pit3rGit/HSP2/kicad_warstwy.docx

#### 5.3.2. Pary warstw technicznych

Kleju (F.Adhes i B.Adhes)

Warstwy kleju są używane przy mocowaniu elementów SMD za pomocą kleju w przypadku obwodów drukowanych, których montaż odbywa się przez lutowanie na fali (Wave soldering).

Pasty (F.Paste i B.Paste)

Warstwy pasty lutowniczej (Solder Paste) dla elementów SMD są używane do produkcji szablonów pozwalających aplikować pastę lutowniczą wyłącznie na polach lutowniczych przeznaczonych dla elementów montowanych powierzchniowo w piecach rozpływowych (Reflow soldering). Teoretycznie tylko elementy montowane powierzchniowo zajmują te warstwy.

Opisowa (F.SilkS i B.SilkS)

Warstwy opisowe są używane do rysowania uproszczonych obrysów elementów. Są przeznaczone do rysowania grafiki przedstawiającej polaryzację elementu, znaczników desymetryzujących, referencji, czy też zwykłych tekstów z opisem.

Maski (F.Mask i B.Mask)

Warstwy anty-cynowania definiują maskę wykorzystywane przy wstępnym cynowaniu PCB. Normalnie wszystkie pola lutownicze jakie znajdują się na jednej (montaż SMT) lub na obu stronach (montaż THT) są maskowane, aby zapobiegać pokryciu ich lakierem (zwanym popularnie Soldermaską) w końcowym procesie produkcyjnym.

Otoczenia (F.CrtYd i B.CrtYd)

Używane do określania ile miejsca fizycznie zajmuje komponent na płytce PCB z zapasem dla automatów montujących.

Produkcyjna (F.Fab i B.Fab)

Używane do rysowania planu rozkładu elementów na płytce. Plan ten jest wykorzystywany przy programowaniu automatów montujących elementy i przy finalnym sprawdzaniu poprawności obsadzenia tych elementów.

#### 5.3.3. Niezależne warstwy techniczne

Krawędziowa (Edge.Cuts)

Warstwa ta jest zarezerwowana dla graficznego opisu obramowania płytki. Dowolny element (grafika, tekst, element pozycjonujący…) umieszczony na tej warstwie zostanie przeniesiony na pozostałe warstwy.

Marginesu (Margin)

Warstwa ta jest przeznaczona do narysowania obrysu elementów wystających poza płytkę.

#### 5.3.4. Warstwy dla własnego użytku

Warstwy te można używać swobodnie. Można na nich przykładowo umieszczać teksty instrukcji dla montażystów lub z opisem połączeń, albo też rysunki konstrukcyjne. Ich nazwy to:

- Cmts.User - Warstwa przeznaczona na komentarze użytkownika
- Eco1.User - Warstwa przeznaczona na komentarze dla wytwórcy PCB
- Eco2.User - Warstwa przeznaczona na komentarze dla wytwórcy PCB
- Dwgs.User - Warstwa przeznaczona na rysunki użytkownika
