pit3rGit/HSP2/datasheet/cap footprint.PNG

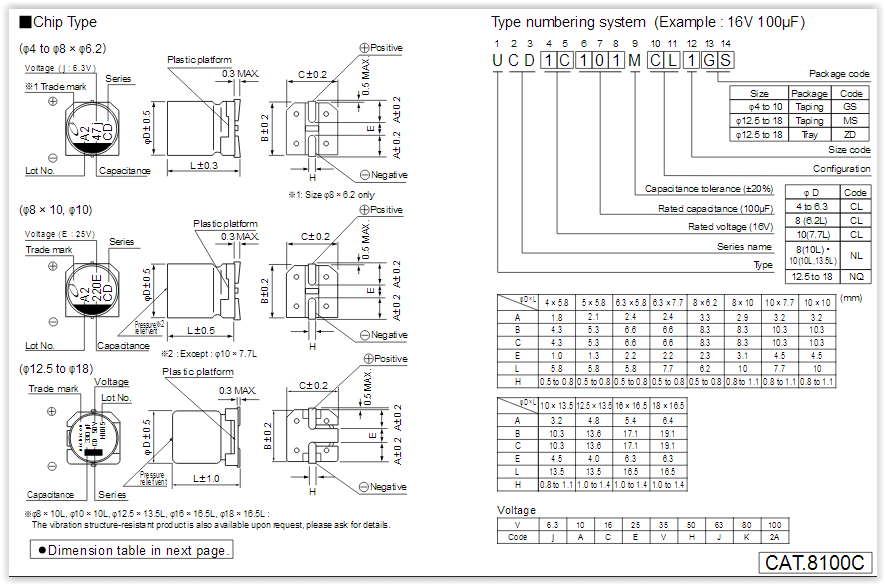
datasheet/cap footprint.PNG
