pit3rGit/HSP2/kosztorys.xlsx

Sheet: PCB
Typ | Producent | Wartość | Obudowa | Ilość | Cena 1 szt. (netto) | Cena całkowita (N szt.) | Ilość do zakupu | Kupiono
Rezystor |  | 1k | 0603R | 21 | 0.004 | 0.08 | 105 | 200
Rezystor |  | 100k | 0603R | 19 | 0.004 | 0.08 | 95 | 100
Rezystor |  | 68k | 0603R | 2 | 0.004 | 0.01 | 10 | 100
Rezystor |  | 60 | 0603R | 1 | 0.004 | 0.004 | 5 | 100 | 60,4 ohma |  | kupione w tme
Rezystor |  | 10k | 0603R | 8 | 0.004 | 0.03 | 40 | 5000
Rezystor |  | 270 | 0603R | 4 | 0.004 | 0.02 | 20 | 100
Rezystor |  | 0 | 0603R | 1 | 0.004 | 0.004 | 5 | 100
Rezystor |  | 200 | 0603R | 1 | 0.004 | 0.004 | 5 | 100
Rezystor |  | 47k | 0603R | 2 | 0.004 | 0.01 | 10 | 50
Rezystor |  | 390 | 0603R | 1 | 0.004 | 0.004 | 5 | 100
 |  |  |  |  |  | 0.00 | 0
Tranzystor |  | IRLML6401 | SOT-23 | 6 | 0.83 | 4.98 | 30 | 36 | IRLML6401TRPBF (https://www.tme.eu/pl/details/irlml6401trpbf/tranzystory-z-kanalem-p-smd/infineon-irf/)
Tranzystor |  | BSS138P.215 (http://www.tme.eu/pl/details/bss138p.215/tranzystory-z-kanalem-n-smd/nexperia/) | SOT-23 | 7 | 0.23 | 1.61 | 35 | 40
Tranzystor |  | FDV304P (http://www.tme.eu/pl/details/fdv304p/tranzystory-z-kanalem-p-smd/on-semiconductor-fairchild/) | SOT-23 | 1 | 0.152 | 0.15 | 5 | 25
 |  |  |  |  |  | 0.00 | 0
Kondensator |  | 1U | 0603C | 21 | 0.055 | 1.16 | 105 | 200 | X5R/25V
Kondensator |  | 13,5P | 0603C | 2 | 0.02 | 0.04 | 10 | 100 | 12p | 100 | 15p
Kondensator |  | 18P | 0603C | 2 | 0.02 | 0.04 | 10 | 100
Kondensator |  | 100N | 0603C | 17 | 0.03 | 0.51 | 85 | 200
Kondensator | TPSD476K016R0080 (https://www.tme.eu/pl/details/tpsd476k016r0080/kondensatory-tantalowe-smd/avx/) | 47u | 2917in | 4 | 2.62 | 10.48 | 20 | 20
Kondensator | T520B476M010ATE035 (http://www.tme.eu/pl/details/t520b476m010ate035/kondensatory-tantalowo-polimerowe/kemet/) | 47U | B, 1411 | 0 | 3.93 | 0.00 | 0 |  | Wycofałem. Niezgodna obudowa.
Kondensator | A755KS108M0JAAE013 (http://www.tme.eu/pl/details/a755ks108m0jaae013/kondensatory-polimerowe/kemet/) | 1000U | 8X3,5mm | 3 | 2.72 | 8.16 | 15 | 18
Kondensator |  | 1N | 0603C | 3 | 0.055 | 0.17 | 15 | 100
Kondensator |  | 100P | 0603C | 2 | 0.03 | 0.06 | 10 | 100
 |  |  |  |  |  | 0.00 | 0
Dwie diody schokty'ego |  | MBRB2535CTLT4G (http://www.tme.eu/pl/details/mbrb2535ctlt4g/diody-schottky-smd/on-semiconductor/) | D3PAK | 1 | 6.81 | 6.81 | 5 | 5
dioda LED | LTST-C193KRKT-5A (http://www.tme.eu/pl/details/ltst-c193krkt-5a/diody-led-smd-kolorowe/liteon/) | LED RED | 0603L | 1 | 0.437 | 0.44 | 5 | 5 | BRAK W TME |  | MOUSER | zapytanie | kupione
dioda LED | LTST-C193KGKT-5A (http://www.tme.eu/pl/details/ltst-c193kgkt-5a/diody-led-smd-kolorowe/liteon/) | LED GREEN | 0603L | 2 | 0.437 | 0.87 | 10 | 15
 |  |  |  |  |  | 0.00 | 0
Bezpiecznik | SCHURTER 3412.0115.11 (http://www.tme.eu/pl/details/3412.0115.11/bezpieczniki-smd-0603-superszybkie/schurter/) | 1A | 0603RH | 6 | 2.34 | 14.04 | 30 | 36
Bezpiecznik | 3413.0326.11 (http://www.tme.eu/pl/details/3413.0326.11/bezpieczniki-smd-1206-zwloczne/schurter/) | 7A | 1206RH | 2 | 2.69 | 5.38 | 10 | 10
Bezpiecznik | Schurter 3413.0010.11 (http://pl.mouser.com/ProductDetail/Schurter/3413001011/) | 250m | 1206RH | 2 | 1.88 | 3.76 | 10 |  | TME |  | MOUSER | zapytanie | brak
Bezpiecznik | SCHURTER 3404.0003.11 (http://www.tme.eu/pl/details/3404.0003.11/bezpieczniki-smd-omf-szybkie/schurter/) | 63m | 7,4x3,1 | 1 | 2.93 | 2.93 | 5 |  | TME |  | MOUSER | zapytanie | brak
 |  |  |  |  |  | 0.00 | 0
Złącze gniazda zewn | Molex | 502584-0670 (http://www.tme.eu/pl/details/mx-502584-0670/zlacza-sygnalowe-raster-150mm/molex/5025840670/) |  | 6 | 2.13 | 12.78 | 30 | 30
Złącze programatora | Molex | 502584-0470 (http://pl.mouser.com/ProductDetail/Molex/502584-0470/) |  | 1 | 1.92 | 1.92 | 5 | 5 | MOUSER |  | MOUSER | zapytanie | kupione
Złącze diody LED | Molex | 502584-0270 (http://pl.mouser.com/ProductDetail/Molex/502584-0270/) |  | 2 | 1.59 | 3.18 | 10 | 10 | MOUSER |  | MOUSER | zapytanie | kupione
Złącze akumulatora | Molex | MX-171813-0004 (http://www.tme.eu/pl/details/mx-171813-0004/zlacza-sygnalowe-raster-396mm/molex/1718130004/) |  | 2 | 2.3 | 4.60 | 10 | 10
Złącze baterii 3,3V | Connfly | DS1092-13-N8S (http://www.tme.eu/pl/details/ds1092-13-n8s/baterie-pojemniki-i-uchwyty/connfly/) |  | 1 | 2.32 | 2.32 | 5 | 10
Złącze karty uSD | Attend | 112C-TBAR-R02 (http://www.tme.eu/pl/details/mcc-sdmicro_1/zlacza-do-kart/attend/112c-tbar-r02/) |  | 1 | 3.73 | 3.73 | 5 | 5
Złącze karty SIM | Amphenol | C707-10M006-049 (http://www.tme.eu/pl/details/c707-10m006-049/zlacza-do-kart/amphenol/c707-10m006-049-2a/) |  | 1 | 3.66 | 3.66 | 5 | 5
 |  |  |  |  |  | 0.00 | 0
Kwarc | Abracon (http://www.tme.eu/pl/details/abs07-32.768khz/rezonatory-kwarcowe-smd/abracon/abs07-32768khz-t/) | ABS07-32.768KHZ (http://www.tme.eu/pl/details/abs07-32.768khz/rezonatory-kwarcowe-smd/abracon/abs07-32768khz-t/) |  | 1 | 5.22 | 5.22 | 5 | 5
Kwarc | ILSI | HC49USM-FF5F8.00 (http://www.tme.eu/pl/details/hc49usm-ff5f8.00/rezonatory-kwarcowe-smd/ilsi/hc49usm-ff5f18-80000/) |  | 1 | 1.76 | 1.76 | 5 | 6
 |  |  |  |  |  | 0.00 | 0
Stabilizator |  | MCP1755T-3302E/DC (http://www.tme.eu/pl/details/mcp1755t-3302e_dc/stabilizatory-napiecia-nieregulowane-ldo/microchip-technology/) | SOT-223-6 | 8 | 4.299 | 34.39 | 40 | 42
Zatrzask |  | 74LVX373M (http://www.tme.eu/pl/details/74lvx373m/zatrzaski/on-semiconductor-fairchild/) | SOIC-20W | 2 | 2.3477 | 4.70 | 10 | 10
RS-485 |  | MAX3485ESA+ (http://www.tme.eu/pl/details/max3485esa+/uklady-scalone-interfejs-rs232422485/maxim-dallas/) | SO-8 | 1 | 22.84 | 22.84 | 5 | 5 | BRAK W TME |  | MOUSER | zapytanie | kupione
Watchdog |  | TPS3823-25QDBVRQ1 (http://pl.rs-online.com/web/p/nadzor-nad-procesorem/7320834/) | SOT-23-5 | 1 | 4.84 | 4.84 | 5 | 5 | RS |  | MOUSER | zapytanie | kupione
ARM |  | STM32L051R8T6 (http://pl.mouser.com/ProductDetail/STMicroelectronics/STM32L051R8T6/) | LQFP-64-10x10 | 1 | 13.9 | 13.90 | 5 | 5 |  |  | MOUSER | zapytanie | kupione
RTC |  | DS3231SN (http://www.tme.eu/pl/details/ds3231sn/uklady-rtc/maxim-dallas/ds3231sn_/) | SO-16-W | 1 | 40.22 | 40.22 | 5 | 5 | BRAK W TME |  | MOUSER | zapytanie | kupione
Stabilizator GSM |  | MIC29302WU (http://www.tme.eu/pl/details/mic29302wu/stabilizatory-napiecia-regulowane-ldo/microchip-micrel/) | TO-263-5 tp6 | 1 | 7.29 | 7.29 | 5 | 5
Czujnik temp i RH |  | DHT22 (https://botland.com.pl/czujniki-temperatury/1612-czujnik-temperatury-i-wilgotnosci-dht22-am2023.html) |  | 1 | 29.9 | 29.90 | 5 | 6 | BOTLAND
GSM |  | M590E (http://www.gotronik.pl/modul-gsm-m590e-zestaw-do-samodzielnego-montazu-p-4067.html) |  | 1 | 16 | 16.00 | 5 | 6 | GOTRONIK
Flash |  | AT45DB161E-SSHD-T (http://www.tme.eu/pl/Document/f6c9d35da09cb9caa899d0d66aa11c4c/AT45DB161E-DTE.pdf) | 8-lead JEDEC SOIC | 1 | 8.7 | 8.70 | 5 | 5
WIFI + BLE |  | ESP-WROOM-32 (https://www.tme.eu/pl/details/esp-wroom-32/moduly-komunikacyjne-pozostale/espressif/) |  | 1 | 20.58 | 20.58 | 5 | 5
 |  |  | SUMA | 178 | SUMA | 304.35
 |  |  |  |  | Liczba PCB | 5.00
 |  |  |  |  | Koszt Całk | 1521.75

Sheet: Obudowa
Nazwa |  |  | Liczba szt. | Całk liczba szt. | Cena 1 szt. | Cena n szt. | Koszt dla n urządzeń | Kupiono
Obudowa | Bopla | Bopla Bocube B 141306 (http://soyter.pl/bopla-uniwersalna-obudowa-bopla-bocube-b-141306-abs-7035-96033225-,c176,p612,pl.html) | 1 | 5 |  | 0 | 0
 |  |  |  | 0 |  | 0 | 0
 |  |  |  | 0 |  | 0 | 0
Złącza zewnętrzne |  |  |  | 0 |  | 0 | 0
Gniazdo sygnalowe | Weipu | SP1312/S6 (http://www.tme.eu/pl/details/sp1312_s6/zlacza-weipu/weipu/) | 6 | 30 | 10.23 | 61.38 | 306.9 | 18
Wtyk sygnałowy | Weipu | SP1310/P6 (http://www.tme.eu/pl/details/sp1310_p6/zlacza-weipu/weipu/sp1310p6i/) | 6 | 30 | 10.84 | 65.04 | 325.2 | 18
 |  |  |  | 0 |  | 0 | 0
 |  |  |  | 0 |  | 0 | 0
Złącza do PCB |  |  |  | 0 |  | 0 | 0
Wtyk 6pin | Molex Clik-Mate | MX-502578-0600 (http://www.tme.eu/pl/details/mx-502578-0600/zlacza-sygnalowe-raster-150mm/molex/5025780600/) | 6 | 30 | 1.14 | 6.84 | 34.2 | 30
styk | Molex Clik-Mate | MX-502579-0000 (http://www.tme.eu/pl/details/mx-502579-0000/zlacza-sygnalowe-raster-150mm/molex/5025790000/) | 44 | 220 | 0.105 | 4.62 | 23.1 | 260
wtyk 4pin | Molex Clik-Mate | MX-502578-0400 (https://www.tme.eu/pl/details/mx-502578-0400/zlacza-sygnalowe-raster-150mm/molex/5025780400/) | 1 | 5 | 1.07 | 1.07 | 5.35 | 8
wtyk 2pin | Molex Clik-Mate | MX-502578-0200 (http://www.tme.eu/pl/details/mx-502578-0200/zlacza-sygnalowe-raster-150mm/molex/5025780200/) | 2 | 10 | 1.02 | 2.04 | 10.2 | 12
wtyk 4pin | KK 396 | MX-2139-4A (http://www.tme.eu/pl/details/mx-2139-4a/zlacza-sygnalowe-raster-396mm/molex/009503041-09-50-3041-2139-4a/) | 2 | 10 | 0.44 | 0.88 | 4.4 | 15
styk do wyboru | KK 396 | MX-2478-1-P913L (http://www.tme.eu/pl/details/mx-2478-1-p913l/zlacza-sygnalowe-raster-396mm/molex/008500106-08-50-0106-2478-1-p909l/) | 0 | 0 |  | 0 | 0 |  | Anulowano wybrano inne
styk do wyboru | KK 396 | MX-6838-P909L (http://www.tme.eu/pl/details/mx-6838-p909l/zlacza-sygnalowe-raster-396mm/molex/008500189-08-50-0189-6838-p909l/) | 8 | 40 |  | 0 | 0 | 70
styk do wyboru | KK 396 | MX-08-52-0072 (http://www.tme.eu/pl/details/mx-08-52-0072/zlacza-sygnalowe-raster-396mm/molex/008520072-2478-3-p909l/) | 0 | 0 |  | 0 | 0 |  | Anulowano wybrano inne
 |  |  |  | Liczba Urządzeń | 5
