pit3rGit/HSP2/datasheet/elementy.ods

Sheet: Sheet1
 | MBRB2535CTLT4G (http://www.tme.eu/pl/details/mbrb2535ctlt4g/diody-schottky-smd/on-semiconductor/) | http://www.tme.eu/pl/details/mbrb2535ctlt4g/diody-schottky-smd/on-semiconductor/#
kond. 2200U | UCD0J222MNL1GS (http://www.tme.eu/pl/details/ucd0j222mnl1gs/kondensatory-elektr-smd-niskoimpedan/nichicon/) | http://www.tme.eu/pl/details/ucd0j222mnl1gs/kondensatory-elektr-smd-niskoimpedan/nichicon/#
kond. MLCC 220u 1210 | CL32A227MQVNNNE (http://www.tme.eu/pl/details/cl32a227mqvnnne/kondensatory-mlcc-smd-1210/samsung/) | http://www.tme.eu/pl/katalog/kondensatory-mlcc-smd-1210_113185/
 | 112C-TBAR-R02 (http://www.tme.eu/pl/details/mcc-sdmicro_1/zlacza-do-kart/attend/112c-tbar-r02/) | http://www.tme.eu/pl/details/mcc-sdmicro_1/zlacza-do-kart/attend/112c-tbar-r02/

Sheet: obliczenia
Stabilizator Wifi
Zakres U | 3,3 | 4,5
Optymalnie | 3,9
Uadj | 1,24
R1 wybrane | 100000
R2 oblczone | 46616,54135
R2 wybrane | 47000
Uwy | 3,878
Pomiar napięcia zasialnia/akumulatora
Napięcie max. | 8 | V
Max. Napięcie ADC | 3,3 | V
R1 wybrane | 100000 | Ohm
R2 oblczone | 70212,76596 | Ohm
R2 wybrane | 68000 | Ohm
U bat max. | 8,152941176 | V
Dla Ubat równego | 6
Uadc wyniesie | 2,428571429 | V
Co da liczbę | 188
Rozdzielczość V | 0,013 | V
