pit3rGit/HSP2/creo/sot-223-6.stl

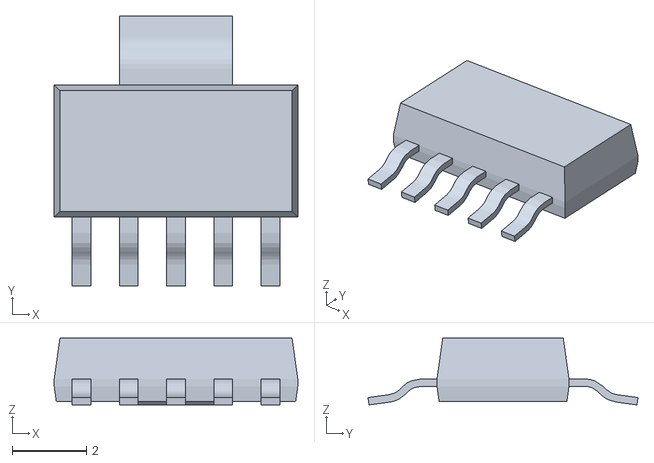
[picture p2: CAD file, 2017-07-28]
creo/sot-223-6.stl
6.55 x 7.26 x 1.80
