pit3rGit/HSP2/creo/dht22.stl

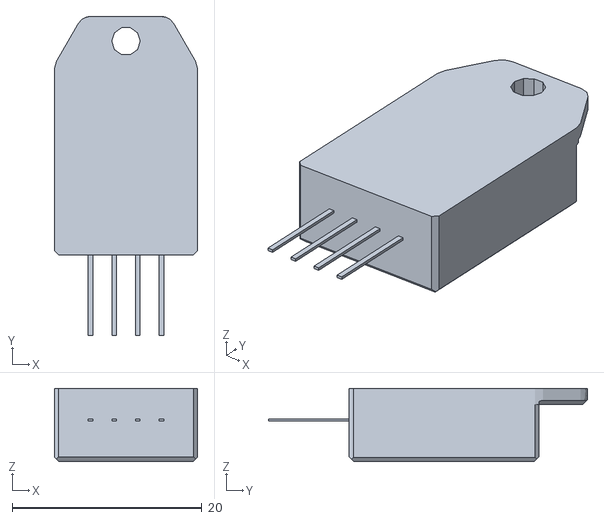
[picture p3: CAD file, 2017-07-28]
creo/dht22.stl
15.1 x 33.6 x 7.70
