pit3rGit/HSP2/creo/WEIPU_SP13_4_Pins.stp

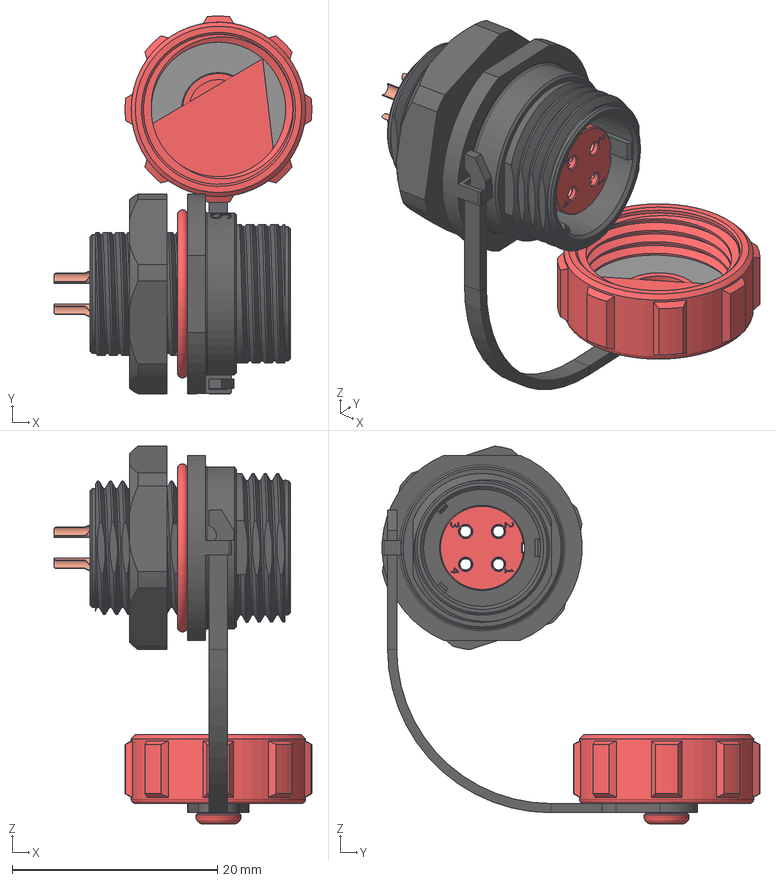
[picture p4: CAD file, 2017-07-27]
creo/WEIPU_SP13_4_Pins.stp
25.1 x 36.8 x 36.8 mm
WEIPU_SP13_4_Pins_Part2
WEIPU_SP13_4_Pins_Part4
WEIPU_SP13_4_Pins_Part5 x 4
WEIPU_SP13_4_Pins_Part3
WEIPU_SP13_4_Pins_Part1
WEIPU_SP13_4_Pins_Part8
WEIPU_SP13_4_Pins_Part6
WEIPU_SP13_4_Pins_Part7
