pit3rGit/HSP2/creo/5025840270.stl

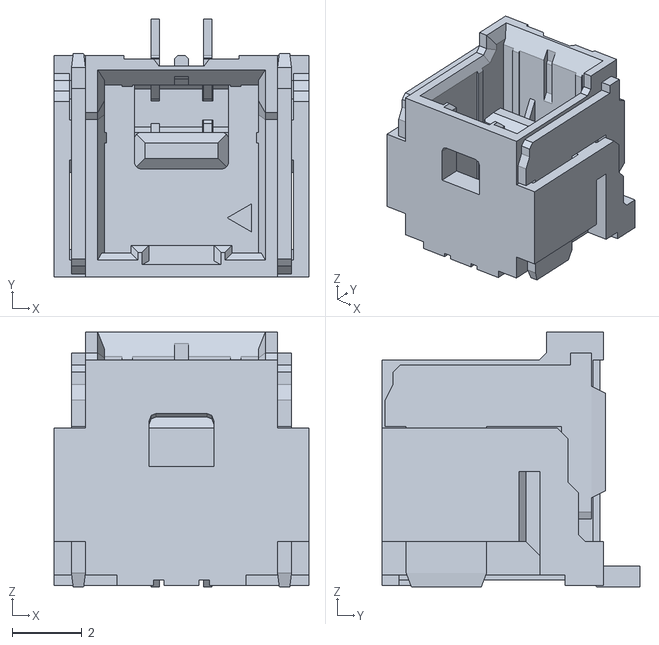
[picture p5: CAD file, 2017-09-05]
creo/5025840270.stl
7.30 x 7.40 x 7.30
