pit3rGit/HSP2/creo/1718130004.stl

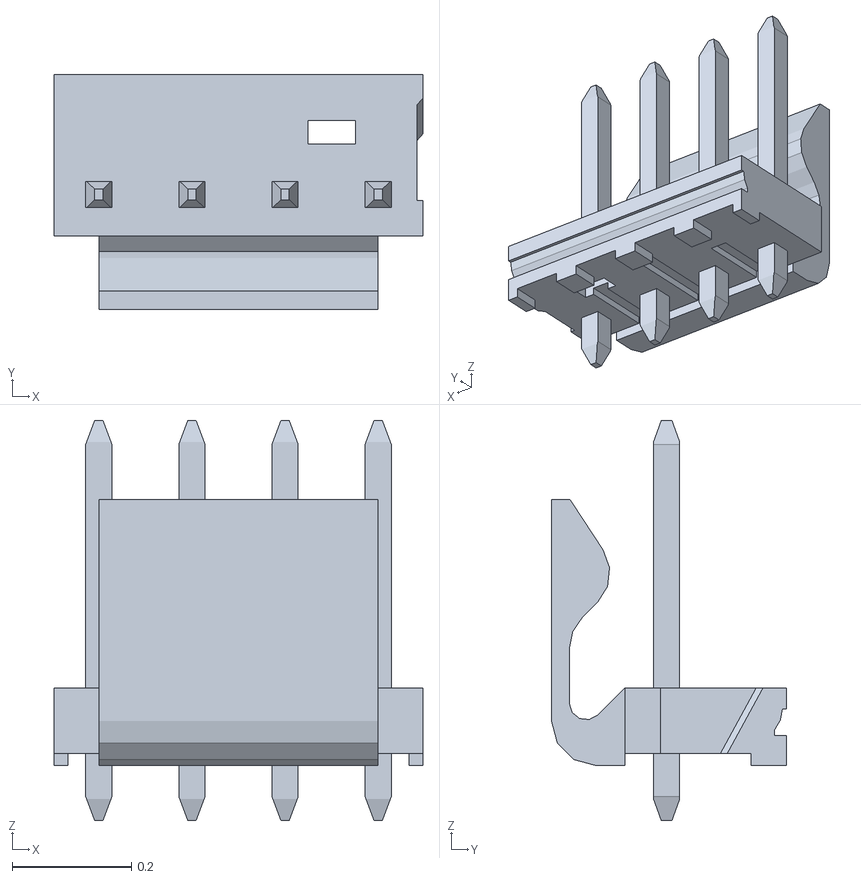
[picture p6: CAD file, 2017-09-05]
creo/1718130004.stl
0.618 x 0.394 x 0.67
