pit3rGit/HSP2/creo/5025840670.stl

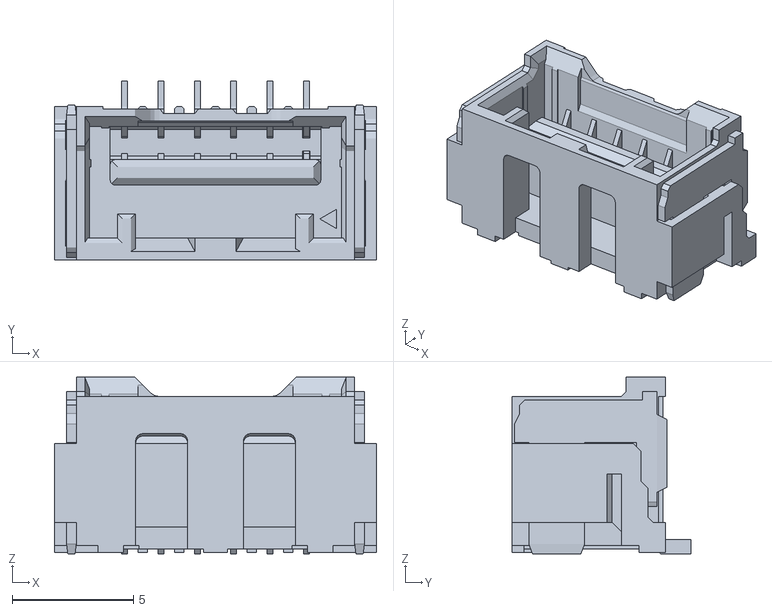
[picture p7: CAD file, 2017-07-28]
creo/5025840670.stl
13.3 x 7.40 x 7.30
