pit3rGit/HSP2/(list of files, cad)

Other CAD files:
creo/1718130004.prt
creo/5025840270.prt
creo/5025840670.prt
creo/SOT-223-6.PRT
