pit3rGit/HSP2/creo/96013225_B_141306_PC-V0_7035.pdf

A-A

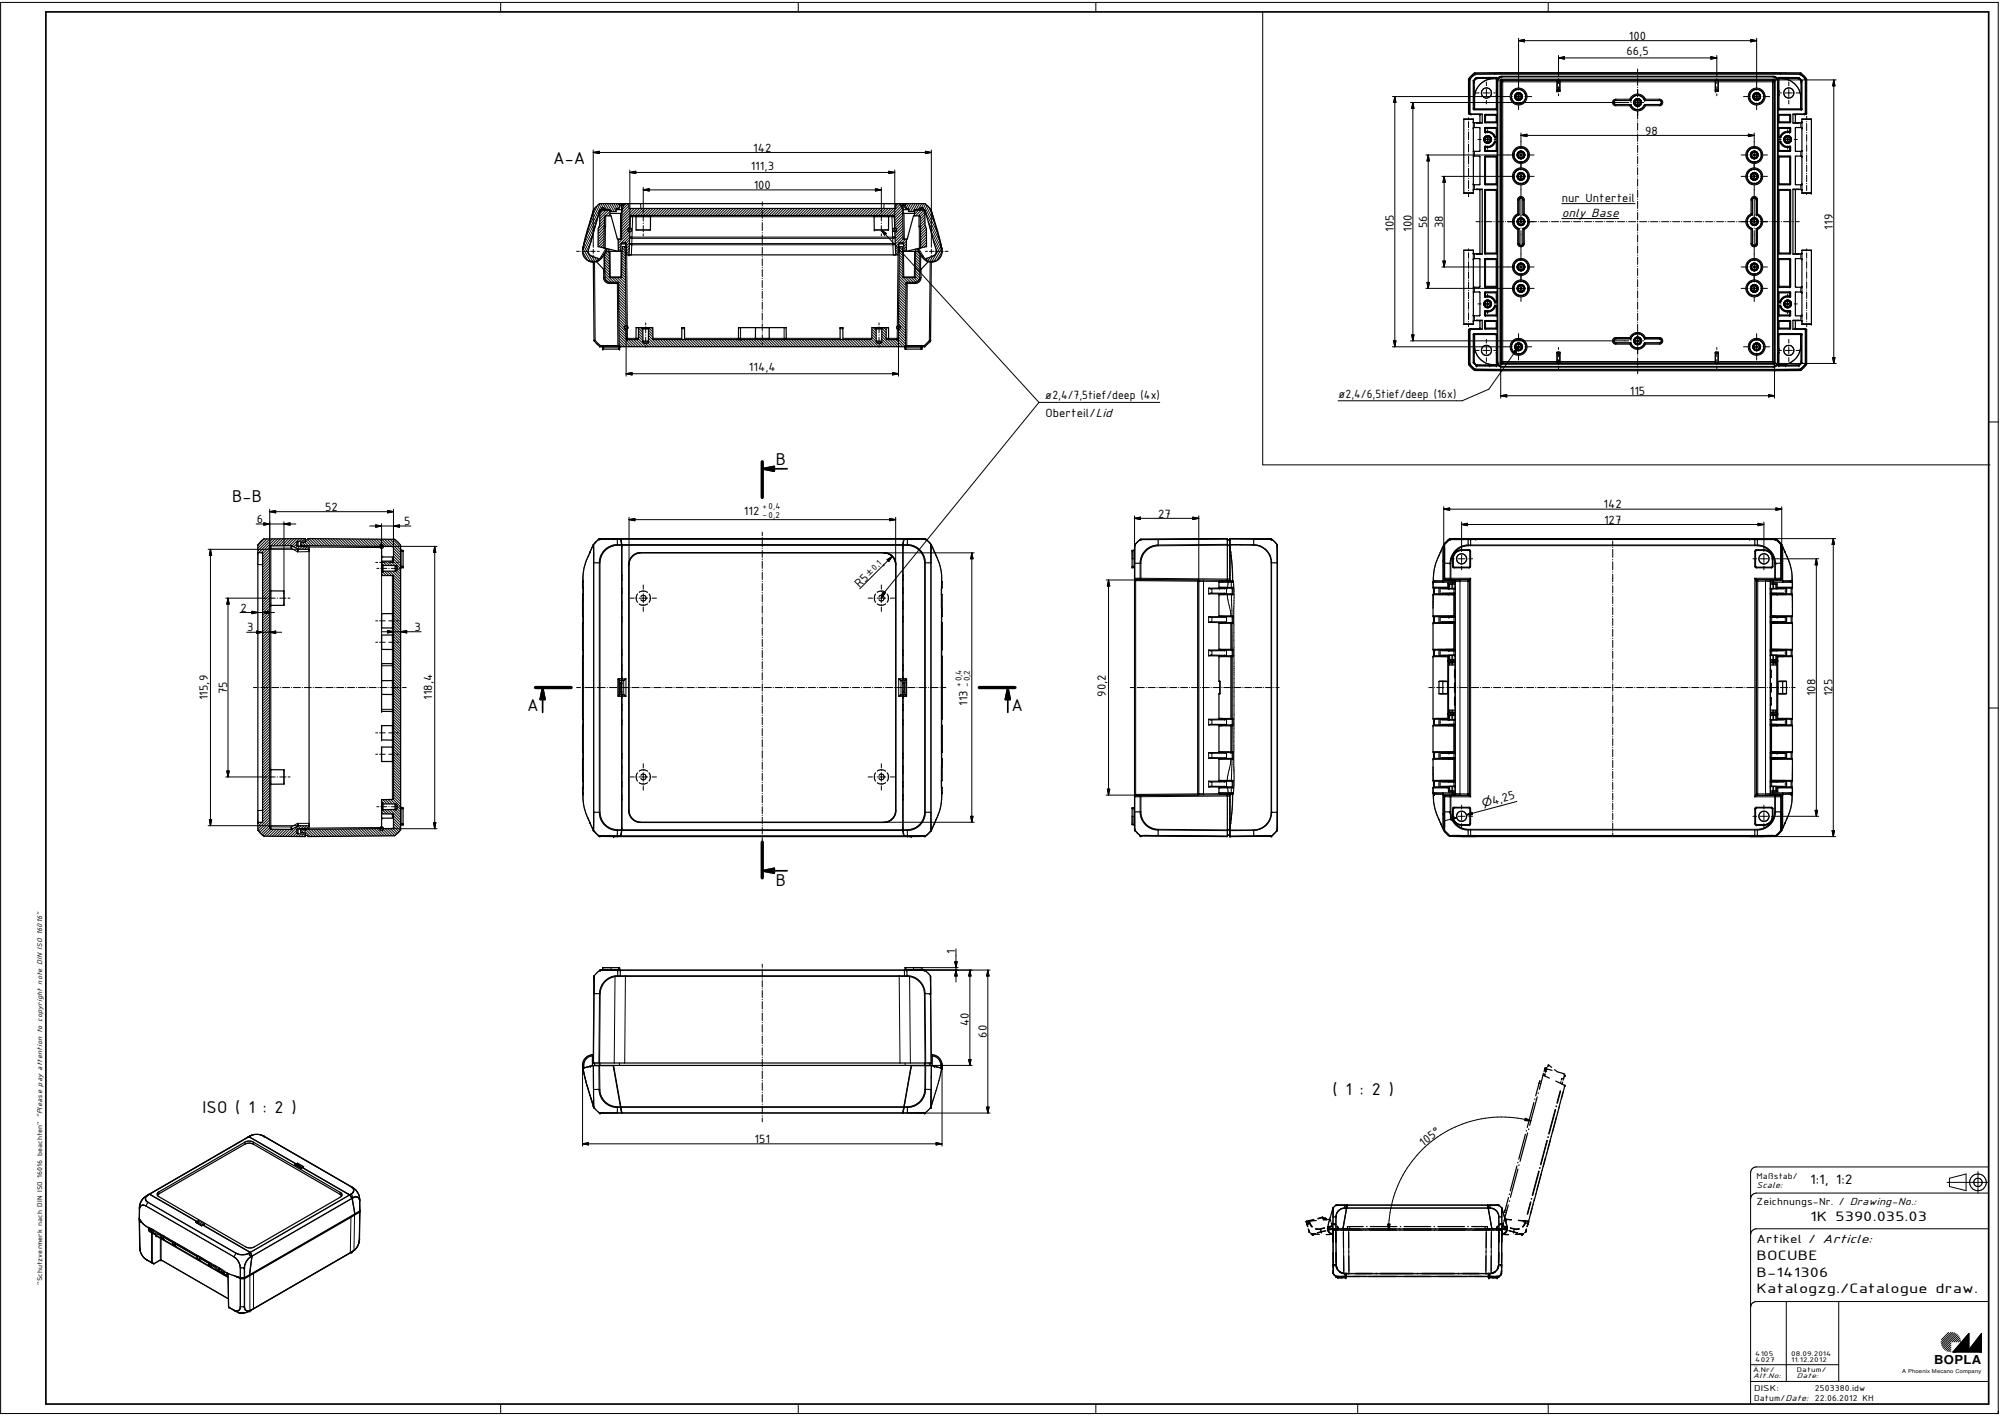
[picture p8: page 1]
ISO ( 1 : 2 ); 2503380.idw 22.06.2012; Datum/; DISK:; Datum/Date:; BOPLA; Alt.No:; Date:; ø2,4/7,5tief/deep (4x); ø2,4/6,5tief/deep (16x); nur Unterteil; only Base; Oberteil/Lid

"Schutzvermerk nach DIN ISO 16016 beachten" "Please pay attention to copyright note DIN ISO 16016"

Maßstab/
Scale:
Zeichnungs-Nr. / Drawing-No.:

Artikel / Article:
BOCUBE
Katalogzg./Catalogue draw.

A Phoenix Mecano Company
