pit3rGit/HSP2/test.kicad_pcb

## KiCad design test.kicad_pcb (2018-01-18)

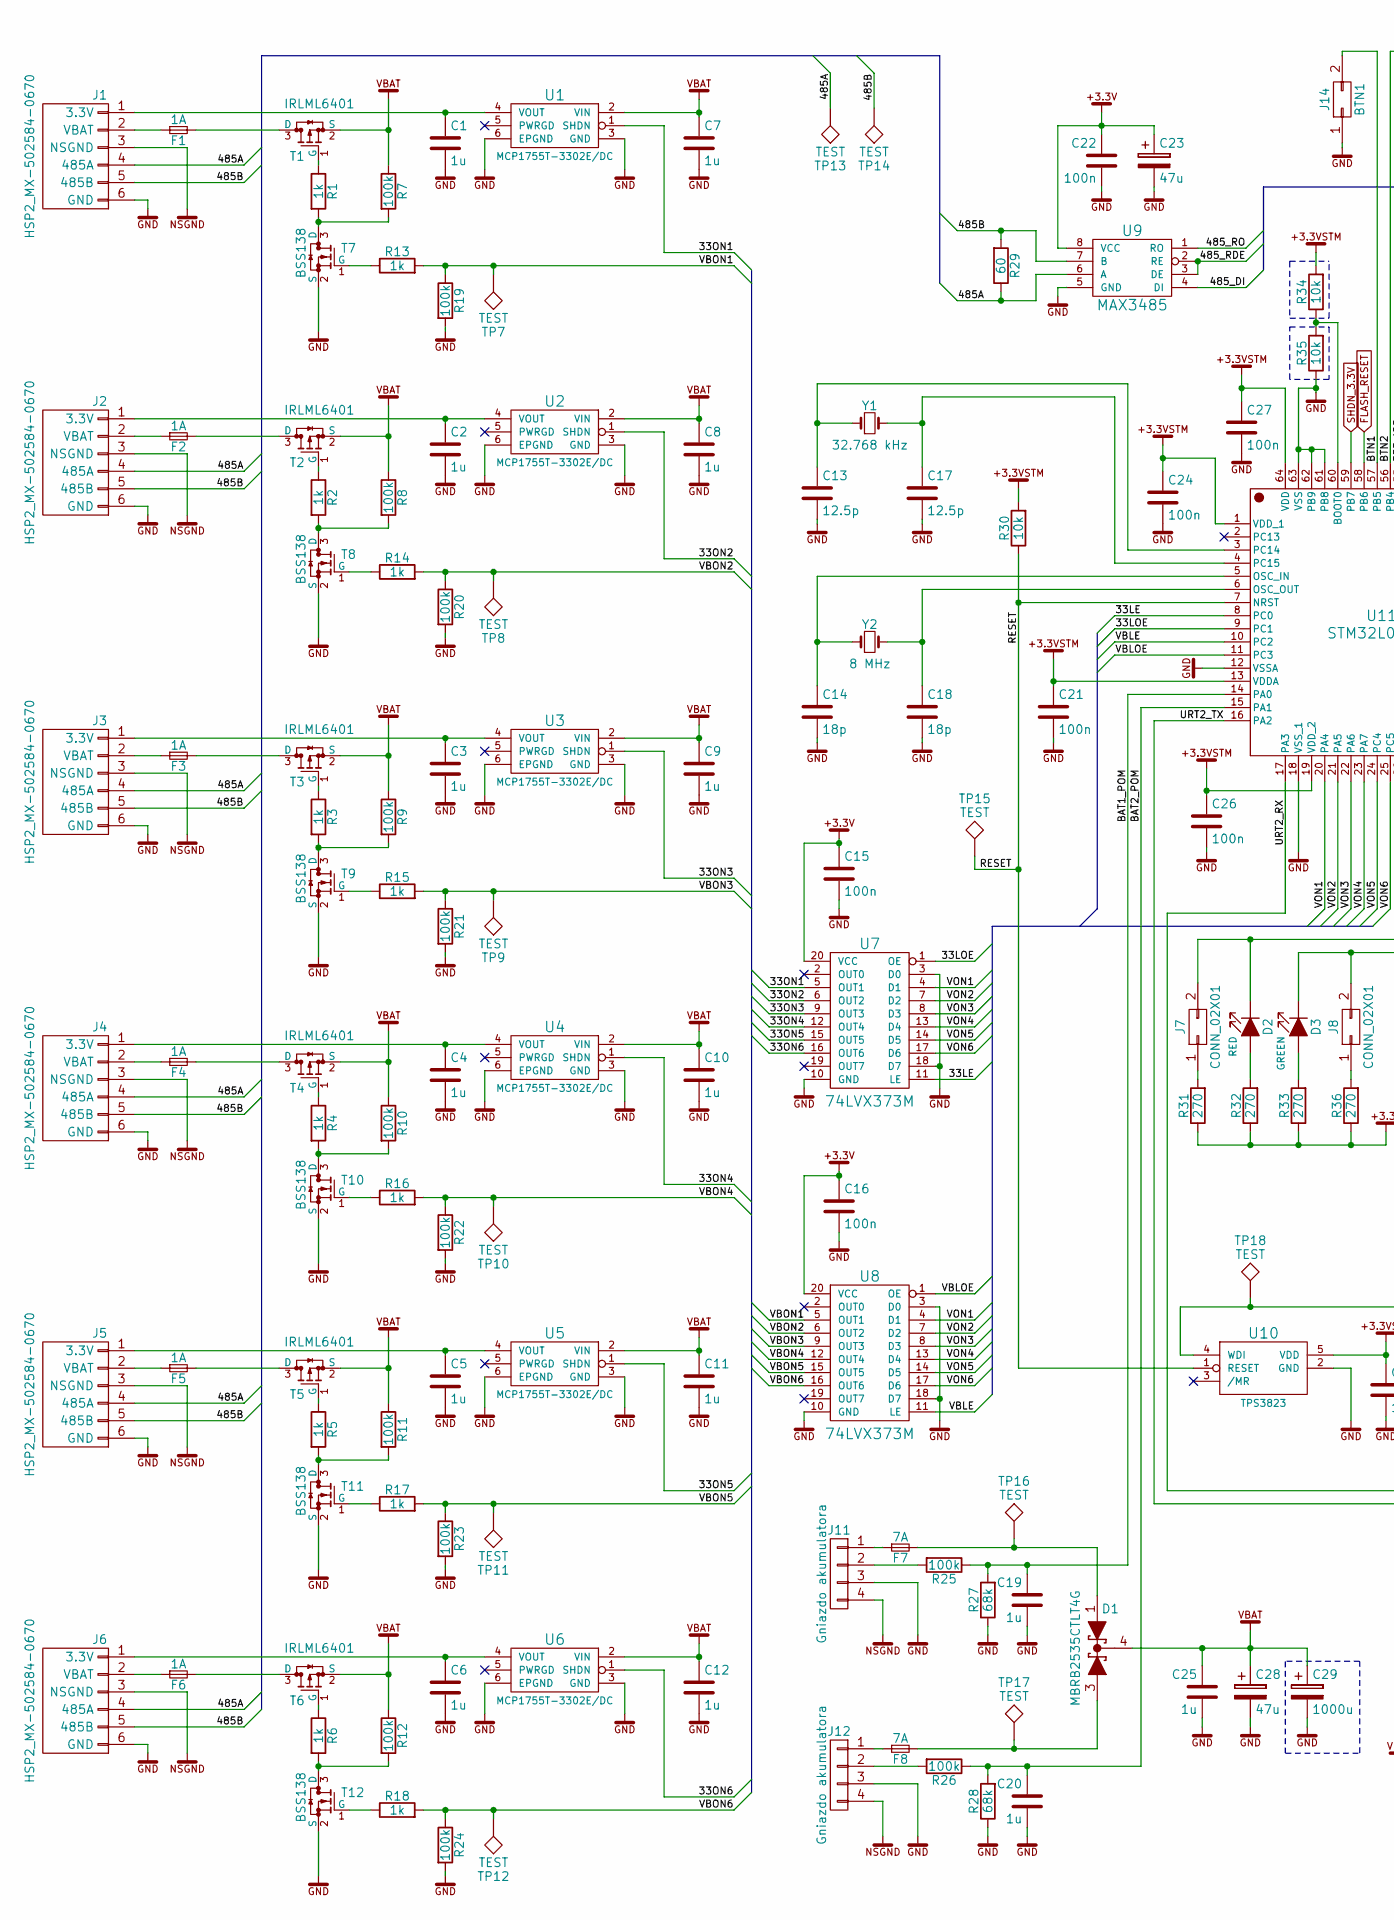
[picture p9: schematic test.sch, HSP2, part in row 1, column 1]

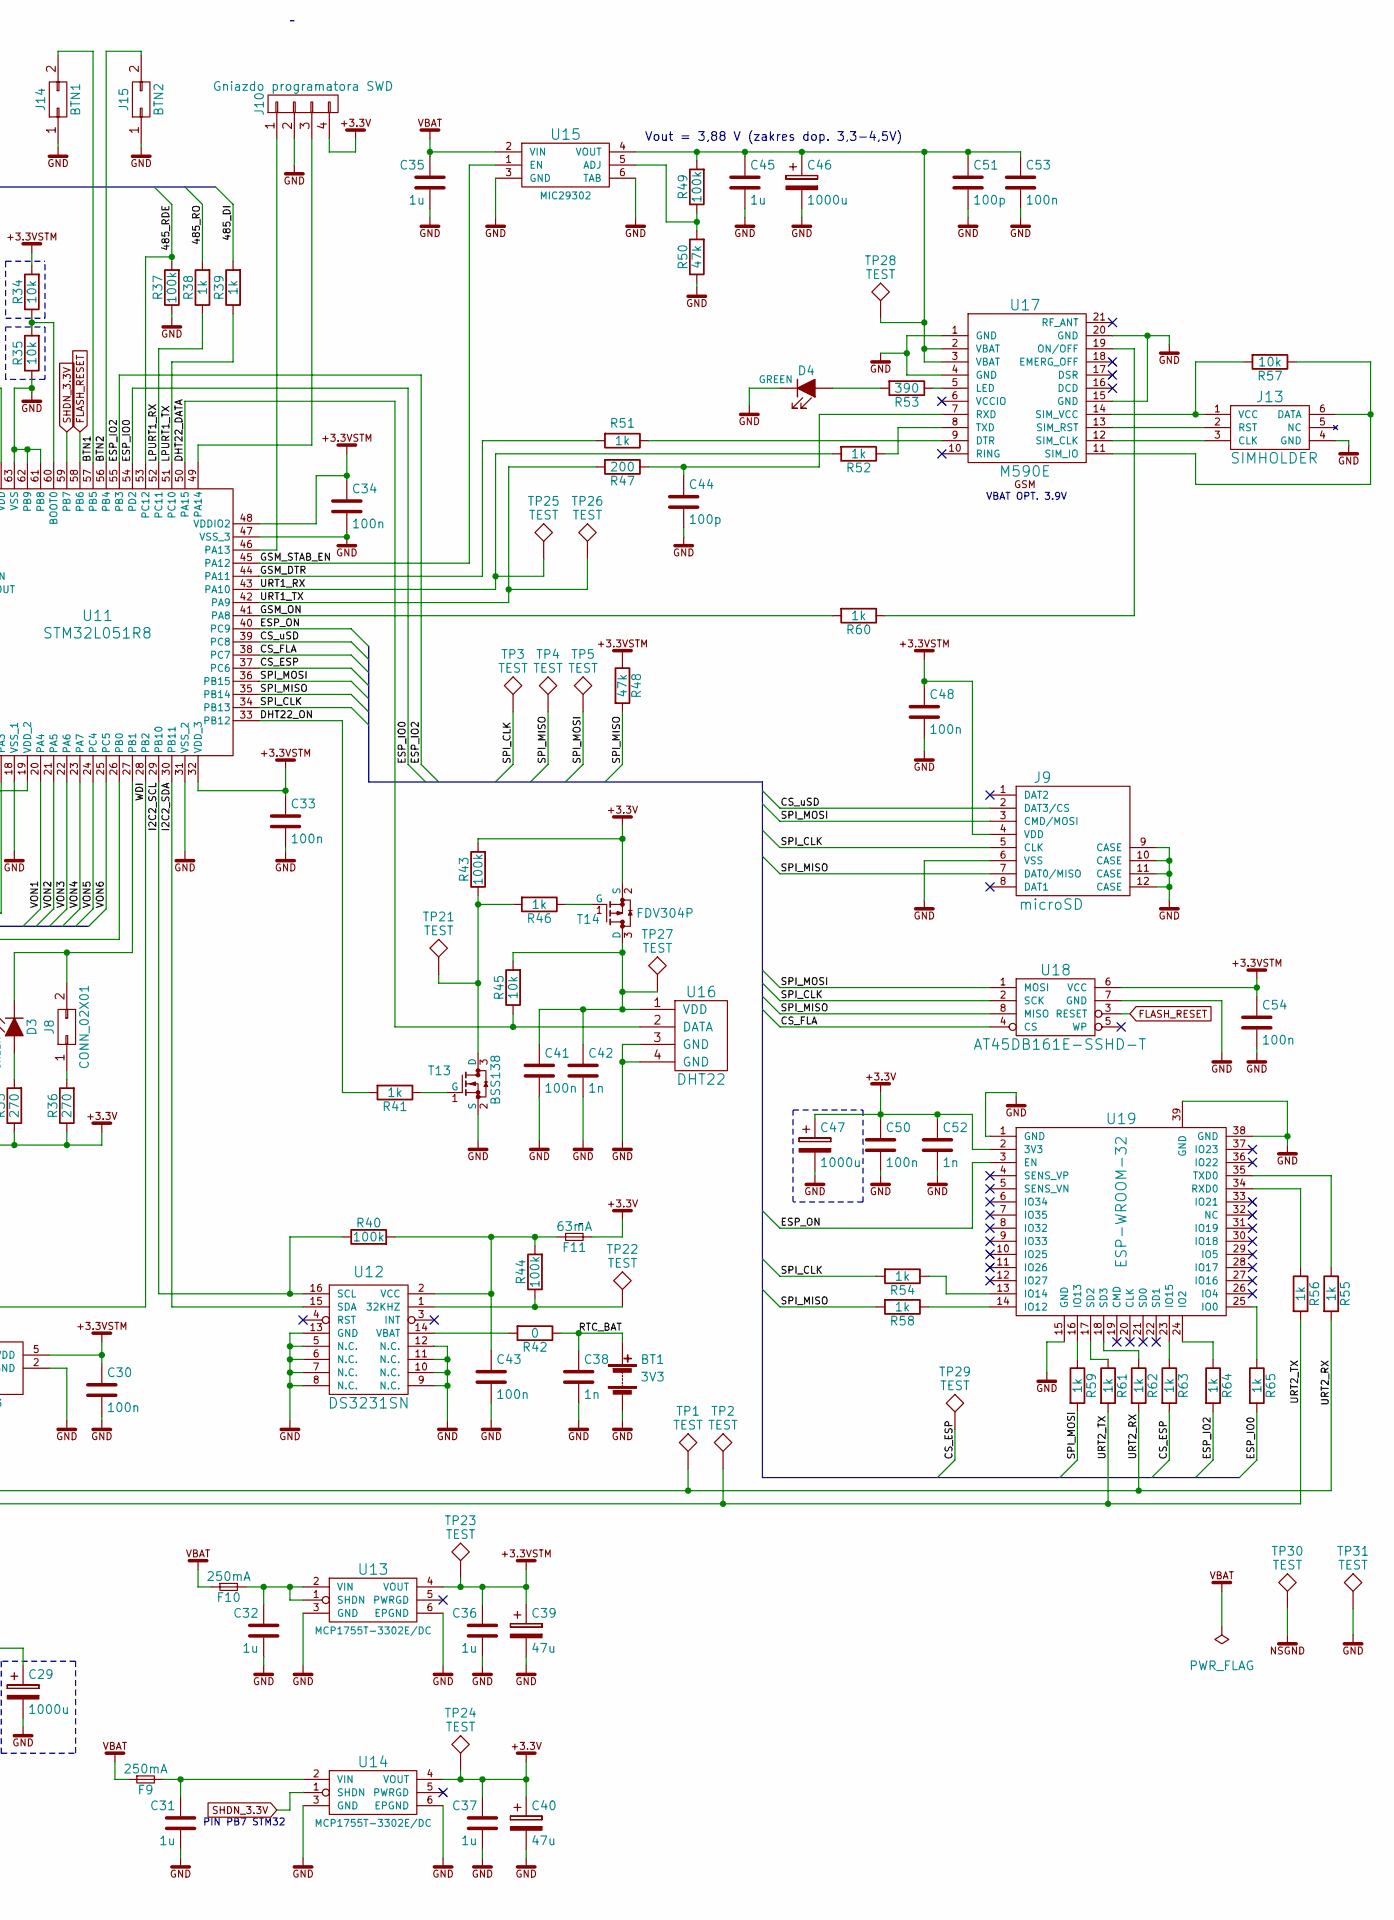
[picture p10: schematic test.sch, HSP2, part in row 1, column 2]

Parts:
BT1: 3V3; CONNFLY_DS1092-13-N8S
C1, C2, C3, C4, C5, C6, C7, C8, C9, C10, C11, C12, C19, C20, C25, C31, C32, C35, C36, C37, C45: 1u; C_0603
C13, C17: 12.5p; C_0603
C14, C18: 18p; C_0603
C15, C16, C21, C22, C24, C26, C27, C30, C33, C34, C41, C43, C48, C50, C53, C54: 100n; C_0603
C23, C28, C39, C40: 47u; 2917in_7343mm
C29, C46, C47: 1000u; CP_Radial_D8.0mm_P3.50mm
C38, C42, C52: 1n; C_0603
C44, C51: 100p; C_0603
D1: MBRB2535CTLT4G; D2PAK
D2: RED; LED_0603
D3, D4: GREEN; LED_0603
F1, F2, F3, F4, F5, F6: 1A; R_0603_HandSoldering
F7, F8: 7A; R_1206_HandSoldering
F9, F10: 250mA; R_1206_HandSoldering
F11: 63mA; SCHURTER_BEZPIECZNIK_OMF63_7.4x3.1
J1, J2, J3, J4, J5, J6: HSP2_MX-502584-0670; MX-502584-0670
J7, J8: CONN_02X01; MX-502584-0270
J9: microSD; ATTEND_uSD_112C_TXAR_R01
J10: Gniazdo programatora SWD; MX-502584-0470
J11, J12: Gniazdo akumulatora; MX-171813-0004
J13: SIMHOLDER; AMPHENOL_SIMHOLDER_C707_10M006_049_2
J14: BTN1; MX-502584-0270
J15: BTN2; MX-502584-0270
R1, R2, R3, R4, R5, R6, R13, R14, R15, R16, R17, R18, R38, R39, R41, R46, R51, R52, R54, R55, R56, R58, R59, R60, R61, R62, R63, R64, R65: 1k; R_0603
R7, R8, R9, R10, R11, R12, R19, R20, R21, R22, R23, R24, R25, R26, R37, R40, R43, R44, R49: 100k; R_0603
R27, R28: 68k; R_0603
R29: 60; R_0603
R30, R34, R35, R45, R57: 10k; R_0603
R31, R32, R33, R36: 270; R_0603
R42: 0; R_0603
R47: 200; R_0603
R48, R50: 47k; R_0603
R53: 390; R_0603
T1, T2, T3, T4, T5, T6: IRLML6401; SOT-23
T7, T8, T9, T10, T11, T12, T13: BSS138; SOT-23
T14: FDV304P; SOT-23
TP1, TP2, TP3, TP4, TP5, TP7, TP8, TP9, TP10, TP11, TP12, TP13, TP14, TP15, TP16, TP17, TP18, TP21, TP22, TP23, TP24, TP25, TP26, TP27, TP28, TP29, TP30, TP31: TEST; Measurement_Point_Round-SMD-Pad_Big
U1, U2, U3, U4, U5, U6, U13, U14: MCP1755T-3302E/DC; SOT-223-6
U7, U8: 74LVX373M; SOIC-20W_7.5x12.8mm_Pitch1.27mm
U9: MAX3485; SO-8
U10: TPS3823; SOT-23-5
U11: STM32L051R8; LQFP-64_10x10mm_Pitch0.5mm
U12: DS3231SN; SO-16-W
U15: MIC29302; TO-263-5_TabPin6
U16: DHT22
U17: M590E
U18: AT45DB161E-SSHD-T; 8-lead_JEDEC_SOIC
U19: ESP-WROOM-32
Y1: 32.768 kHz; Abracon_ABS07
Y2: 8 MHz; Crystal_SMD_HC49-SD_HandSoldering

Connections:
+3.3V: C15.1, C16.1, C22.1, C23.1, C37.1, C40.1, C47.1, C50.1, C52.1, F11.2, J10.4, R31.1, R32.1, R33.1, R36.1, R43.2, T14.2 (S), TP24.1, U7.20 (VCC), U8.20 (VCC), U9.8 (VCC), U14.4 (VOUT), U19.2 (3V3)
+3.3VSTM: C21.1, C24.1, C26.1, C27.1, C30.1, C33.1, C34.1, C36.1, C39.1, C48.1, C54.1, J9.4 (VDD), R30.2, R34.2, R48.1, TP23.1, U10.5 (VDD), U11.1 (VDD_1), U11.13 (VDDA), U11.19 (VDD_2), U11.32 (VDD_3), U11.48 (VDDIO2), U11.64 (VDD), U13.4 (VOUT), U18.6 (VCC)
/33LE: U7.11 (LE), U11.8 (PC0)
/33LOE: U7.1 (OE), U11.9 (PC1)
/33ON1: U1.1 (SHDN), U7.5 (OUT1)
/33ON2: U2.1 (SHDN), U7.6 (OUT2)
/33ON3: U3.1 (SHDN), U7.9 (OUT3)
/33ON4: U4.1 (SHDN), U7.12 (OUT4)
/33ON5: U5.1 (SHDN), U7.15 (OUT5)
/33ON6: U6.1 (SHDN), U7.16 (OUT6)
/485A: J1.4 (485A), J2.4 (485A), J3.4 (485A), J4.4 (485A), J5.4 (485A), J6.4 (485A), R29.1, TP13.1, U9.6 (A)
/485B: J1.5 (485B), J2.5 (485B), J3.5 (485B), J4.5 (485B), J5.5 (485B), J6.5 (485B), R29.2, TP14.1, U9.7 (B)
/485_DI: R39.2, U9.4 (DI)
/485_RDE: R37.2, U9.2 (RE), U9.3 (DE), U11.53 (PC12)
/485_RO: R38.2, U9.1 (RO)
/BAT1_POM: C19.1, R25.1, R27.2, U11.14 (PA0)
/BAT2_POM: C20.1, R26.1, R28.2, U11.15 (PA1)
/BTN1: J14.2, U11.57 (PB5)
/BTN2: J15.2, U11.56 (PB4)
/CS_ESP: R63.2, TP29.1, U11.37 (PC6)
/CS_FLA: U11.38 (PC7), U18.4 (CS)
/CS_uSD: J9.2 (DAT3/CS), U11.39 (PC8)
/DHT22_DATA: R45.1, U11.50 (PA15), U16.2 (DATA)
/DHT22_ON: R41.2, U11.33 (PB12)
/ESP_IO0: R65.2, U11.54 (PD2)
/ESP_IO2: R64.2, U11.55 (PB3)
/ESP_ON: U11.40 (PC9), U19.3 (EN)
/GSM_DTR: R51.2, U11.44 (PA11)
/GSM_ON: R60.2, U11.41 (PA8)
/GSM_STAB_EN: U11.45 (PA12), U15.1 (EN)
/I2C2_SCL: R40.1, U11.29 (PB10), U12.16 (SCL)
/I2C2_SDA: U11.30 (PB11), U12.15 (SDA)
/LPURT1_RX: R38.1, U11.52 (PC11)
/LPURT1_TX: R39.1, U11.51 (PC10)
/RESET: R30.1, TP15.1, U10.1 (RESET), U11.7 (NRST)
/RTC_BAT: BT1.1 (+), C38.1, R42.1
/SPI_CLK: J9.5 (CLK), R54.2, TP3.1, U11.34 (PB13), U18.2 (SCK)
/SPI_MISO: J9.7 (DAT0/MISO), R48.2, R58.2, TP4.1, U11.35 (PB14), U18.8 (MISO)
/SPI_MOSI: J9.3 (CMD/MOSI), R59.2, TP5.1, U11.36 (PB15), U18.1 (MOSI)
/URT1_RX: R52.2, TP25.1, U11.43 (PA10)
/URT1_TX: R47.2, TP26.1, U11.42 (PA9)
/URT2_RX: R55.2, R62.2, TP1.1, U11.17 (PA3)
/URT2_TX: R56.2, R61.2, TP2.1, U11.16 (PA2)
/VBLE: U8.11 (LE), U11.10 (PC2)
/VBLOE: U8.1 (OE), U11.11 (PC3)
/VBON1: R13.2, R19.1, TP7.1, U8.5 (OUT1)
/VBON2: R14.2, R20.1, TP8.1, U8.6 (OUT2)
/VBON3: R15.2, R21.1, TP9.1, U8.9 (OUT3)
/VBON4: R16.2, R22.1, TP10.1, U8.12 (OUT4)
/VBON5: R17.2, R23.1, TP11.1, U8.15 (OUT5)
/VBON6: R18.2, R24.1, TP12.1, U8.16 (OUT6)
/VON1: U7.4 (D1), U8.4 (D1), U11.20 (PA4)
/VON2: U7.7 (D2), U8.7 (D2), U11.21 (PA5)
/VON3: U7.8 (D3), U8.8 (D3), U11.22 (PA6)
/VON4: U7.13 (D4), U8.13 (D4), U11.23 (PA7)
/VON5: U7.14 (D5), U8.14 (D5), U11.24 (PC4)
/VON6: U7.17 (D6), U8.17 (D6), U11.25 (PC5)
/WDI: TP18.1, U10.4 (WDI), U11.28 (PB2)
FLASH_RESET: U11.58 (PB6), U18.3 (RESET)
GND: BT1.2 (-), C1.2, C2.2, C3.2, C4.2, C5.2, C6.2, C7.2, C8.2, C9.2, C10.2, C11.2, C12.2, C13.2, C14.2, C15.2, C16.2, C17.2, C18.2, C19.2, C20.2, C21.2, C22.2, C23.2, C24.2, C25.2, C26.2, C27.2, C28.2, C29.2, C30.2, C31.2, C32.2, C33.2, C34.2, C35.2, C36.2, C37.2, C38.2, C39.2, C40.2, C41.2, C42.2, C43.2, C44.2, C45.2, C46.2, C47.2, C48.2, C50.2, C51.2, C52.2, C53.2, C54.2, D4.1 (K), J1.6 (GND), J2.6 (GND), J3.6 (GND), J4.6 (GND), J5.6 (GND), J6.6 (GND), J9.6 (VSS), J9.9 (CASE), J9.10 (CASE), J9.11 (CASE), J9.12 (CASE), J10.2, J11.3, J12.3, J13.4 (GND), J14.1, J15.1, R19.2, R20.2, R21.2, R22.2, R23.2, R24.2, R27.1, R28.1, R35.1, R37.1, R50.1, T7.2 (S), T8.2 (S), T9.2 (S), T10.2 (S), T11.2 (S), T12.2 (S), T13.2 (S), TP31.1, U1.3 (GND), U1.6 (EPGND), U2.3 (GND), U2.6 (EPGND), U3.3 (GND), U3.6 (EPGND), U4.3 (GND), U4.6 (EPGND), U5.3 (GND), U5.6 (EPGND), U6.3 (GND), U6.6 (EPGND), U7.3 (D0), U7.10 (GND), U7.18 (D7), U8.3 (D0), U8.10 (GND), U8.18 (D7), U9.5 (GND), U10.2 (GND), U11.12 (VSSA), U11.18 (VSS_1), U11.31 (VSS_2), U11.47 (VSS_3), U11.61 (PB8), U11.62 (PB9), U11.63 (VSS), U12.5 (N.C.), U12.6 (N.C.), U12.7 (N.C.), U12.8 (N.C.), U12.9 (N.C.), U12.10 (N.C.), U12.11 (N.C.), U12.12 (N.C.), U12.13 (GND), U13.3 (GND), U13.6 (EPGND), U14.3 (GND), U14.6 (EPGND), U15.3 (GND), U15.6 (TAB), U16.3 (GND), U16.4 (GND), U17.1 (GND), U17.4 (GND), U17.15 (GND), U17.20 (GND), U18.7 (GND), U19.1 (GND), U19.15 (GND), U19.38 (GND), U19.39 (GND)
unnamed: C1.1, J1.1 (3.3V), U1.4 (VOUT)
unnamed: C2.1, J2.1 (3.3V), U2.4 (VOUT)
unnamed: C3.1, J3.1 (3.3V), U3.4 (VOUT)
unnamed: C4.1, J4.1 (3.3V), U4.4 (VOUT)
unnamed: C5.1, J5.1 (3.3V), U5.4 (VOUT)
unnamed: C6.1, J6.1 (3.3V), U6.4 (VOUT)
unnamed: C13.1, U11.3 (PC14), Y1.1
unnamed: C14.1, U11.5 (OSC_IN), Y2.1
unnamed: C17.1, U11.4 (PC15), Y1.2
unnamed: C18.1, U11.6 (OSC_OUT), Y2.2
unnamed: C31.1, F9.2, U14.2 (VIN)
unnamed: C32.1, F10.2, U13.1 (SHDN), U13.2 (VIN)
unnamed: C41.1, C42.1, R45.2, T14.3 (D), TP27.1, U16.1 (VDD)
unnamed: C43.1, F11.1, R40.2, R44.2, U12.2 (VCC)
unnamed: C44.1, R47.1, U17.7 (RXD)
unnamed: C45.1, C46.1, C51.1, C53.1, R49.2, TP28.1, U15.4 (VOUT), U17.2 (VBAT), U17.3 (VBAT)
unnamed: D1.1 (A), F7.2, TP16.1
unnamed: D1.3 (A), F8.2, TP17.1
unnamed: D2.1 (K), J7.2, U11.26 (PB0)
unnamed: D2.2 (A), R32.2
unnamed: D3.1 (K), J8.2, U11.27 (PB1)
unnamed: D3.2 (A), R33.2
unnamed: D4.2 (A), R53.2
unnamed: F1.1, J1.2 (VBAT)
unnamed: F1.2, T1.3 (D)
unnamed: F2.1, J2.2 (VBAT)
unnamed: F2.2, T2.3 (D)
unnamed: F3.1, J3.2 (VBAT)
unnamed: F3.2, T3.3 (D)
unnamed: F4.1, J4.2 (VBAT)
unnamed: F4.2, T4.3 (D)
unnamed: F5.1, J5.2 (VBAT)
unnamed: F5.2, T5.3 (D)
unnamed: F6.1, J6.2 (VBAT)
unnamed: F6.2, T6.3 (D)
unnamed: F7.1, J11.1
unnamed: F8.1, J12.1
unnamed: J7.1, R31.2
unnamed: J8.1, R36.2
unnamed: J10.1, U11.46 (PA13)
unnamed: J10.3, U11.49 (PA14)
unnamed: J11.2, R25.2
unnamed: J12.2, R26.2
unnamed: J13.1 (VCC), R57.2, U17.14 (SIM_VCC)
unnamed: J13.2 (RST), U17.13 (SIM_RST)
unnamed: J13.3 (CLK), U17.12 (SIM_CLK)
unnamed: J13.6 (DATA), R57.1, U17.11 (SIM_IO)
unnamed: R1.1, T1.1 (G)
unnamed: R1.2, R7.2, T7.3 (D)
unnamed: R2.1, T2.1 (G)
unnamed: R2.2, R8.2, T8.3 (D)
unnamed: R3.1, T3.1 (G)
unnamed: R3.2, R9.2, T9.3 (D)
unnamed: R4.1, T4.1 (G)
unnamed: R5.1, T5.1 (G)
unnamed: R6.1, T6.1 (G)
unnamed: R4.2, R10.2, T10.3 (D)
unnamed: R5.2, R11.2, T11.3 (D)
unnamed: R6.2, R12.2, T12.3 (D)
unnamed: R13.1, T7.1 (G)
unnamed: R14.1, T8.1 (G)
unnamed: R15.1, T9.1 (G)
unnamed: R16.1, T10.1 (G)
unnamed: R17.1, T11.1 (G)
unnamed: R18.1, T12.1 (G)
unnamed: R34.1, R35.2, U11.60 (BOOT0)
unnamed: R41.1, T13.1 (G)
unnamed: R42.2, U12.14 (VBAT)
unnamed: R43.1, R46.2, T13.3 (D), TP21.1
unnamed: R44.1, TP22.1, U12.1 (32KHZ)
unnamed: R46.1, T14.1 (G)
unnamed: R49.1, R50.2, U15.5 (ADJ)
unnamed: R51.1, U17.9 (DTR)
unnamed: R52.1, U17.8 (TXD)
unnamed: R53.1, U17.5 (LED)
unnamed: R54.1, U19.13 (IO14)
unnamed: R55.1, U19.35 (TXD0)
unnamed: R56.1, U19.34 (RXD0)
unnamed: R58.1, U19.14 (IO12)
unnamed: R59.1, U19.16 (IO13)
unnamed: R60.1, U17.19 (ON/OFF)
unnamed: R61.1, U19.17 (SD2)
unnamed: R62.1, U19.18 (SD3)
unnamed: R63.1, U19.23 (IO15)
unnamed: R64.1, U19.24 (IO2)
unnamed: R65.1, U19.25 (IO0)
SHDN_3.3V: U11.59 (PB7), U14.1 (SHDN)
VBAT: C7.1, C8.1, C9.1, C10.1, C11.1, C12.1, C25.1, C28.1, C29.1, C35.1, D1.4 (K), F9.1, F10.1, R7.1, R8.1, R9.1, R10.1, R11.1, R12.1, T1.2 (S), T2.2 (S), T3.2 (S), T4.2 (S), T5.2 (S), T6.2 (S), U1.2 (VIN), U2.2 (VIN), U3.2 (VIN), U4.2 (VIN), U5.2 (VIN), U6.2 (VIN), U15.2 (VIN)
~: J1.3 (NSGND), J2.3 (NSGND), J3.3 (NSGND), J4.3 (NSGND), J5.3 (NSGND), J6.3 (NSGND), J11.4, J12.4, TP30.1

Notes on the sheet:
VBAT OPT. 3.9V
Vout = 3,88 V (zakres dop. 3,3-4,5V)
PIN PB7 STM32

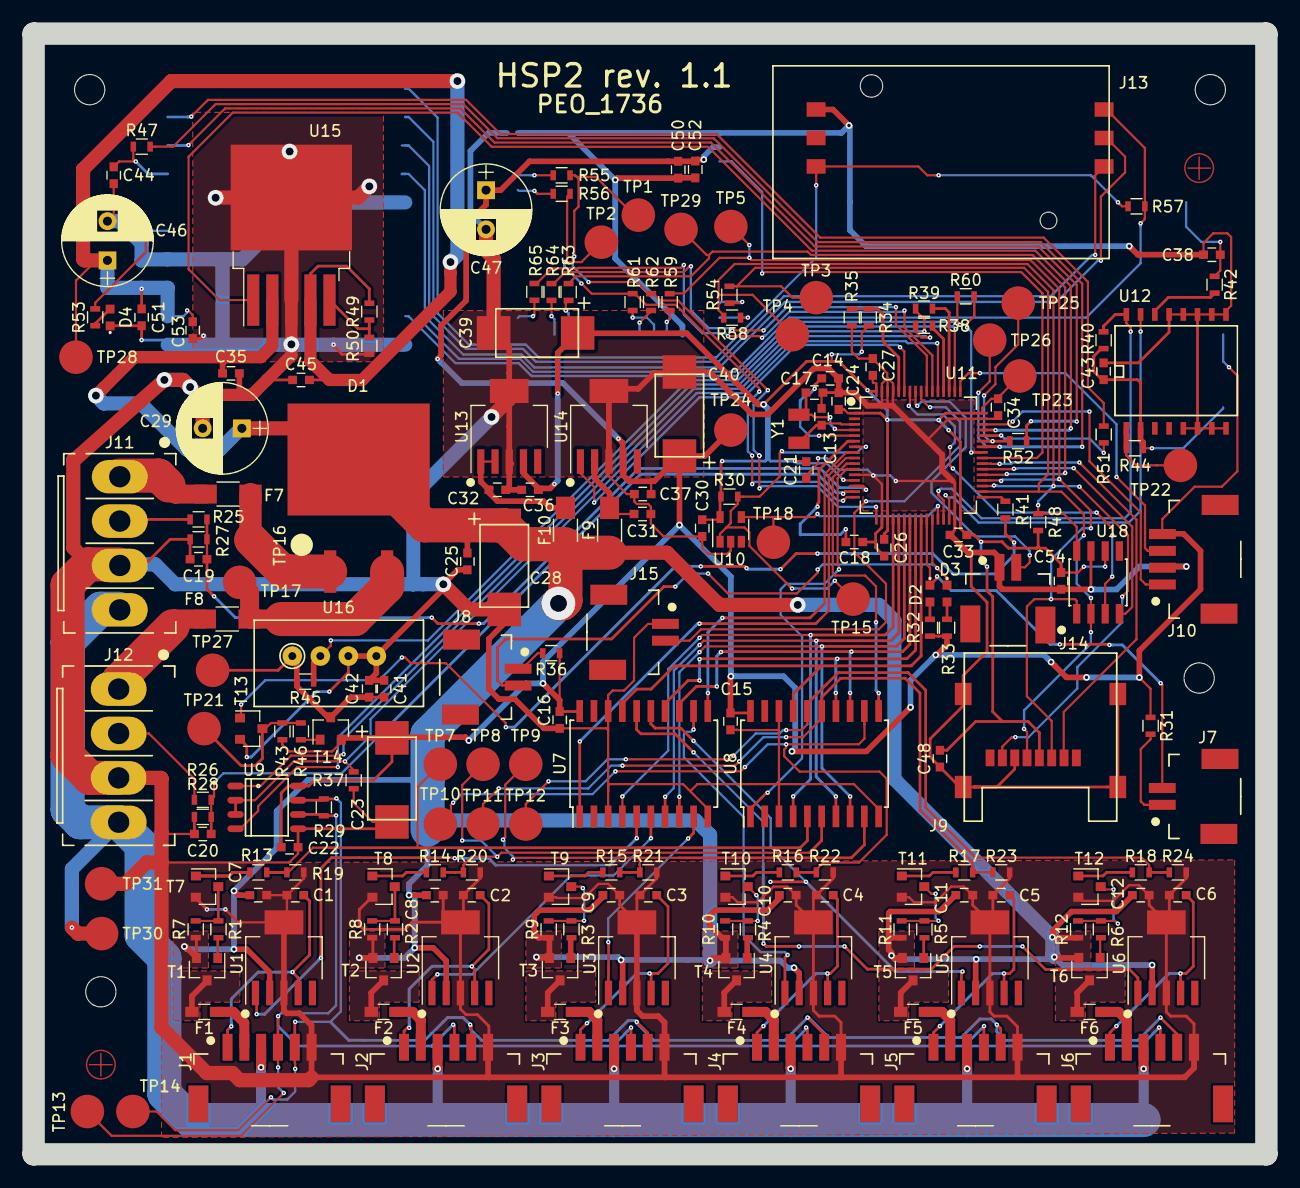
[picture p11: board test.kicad_pcb from above]

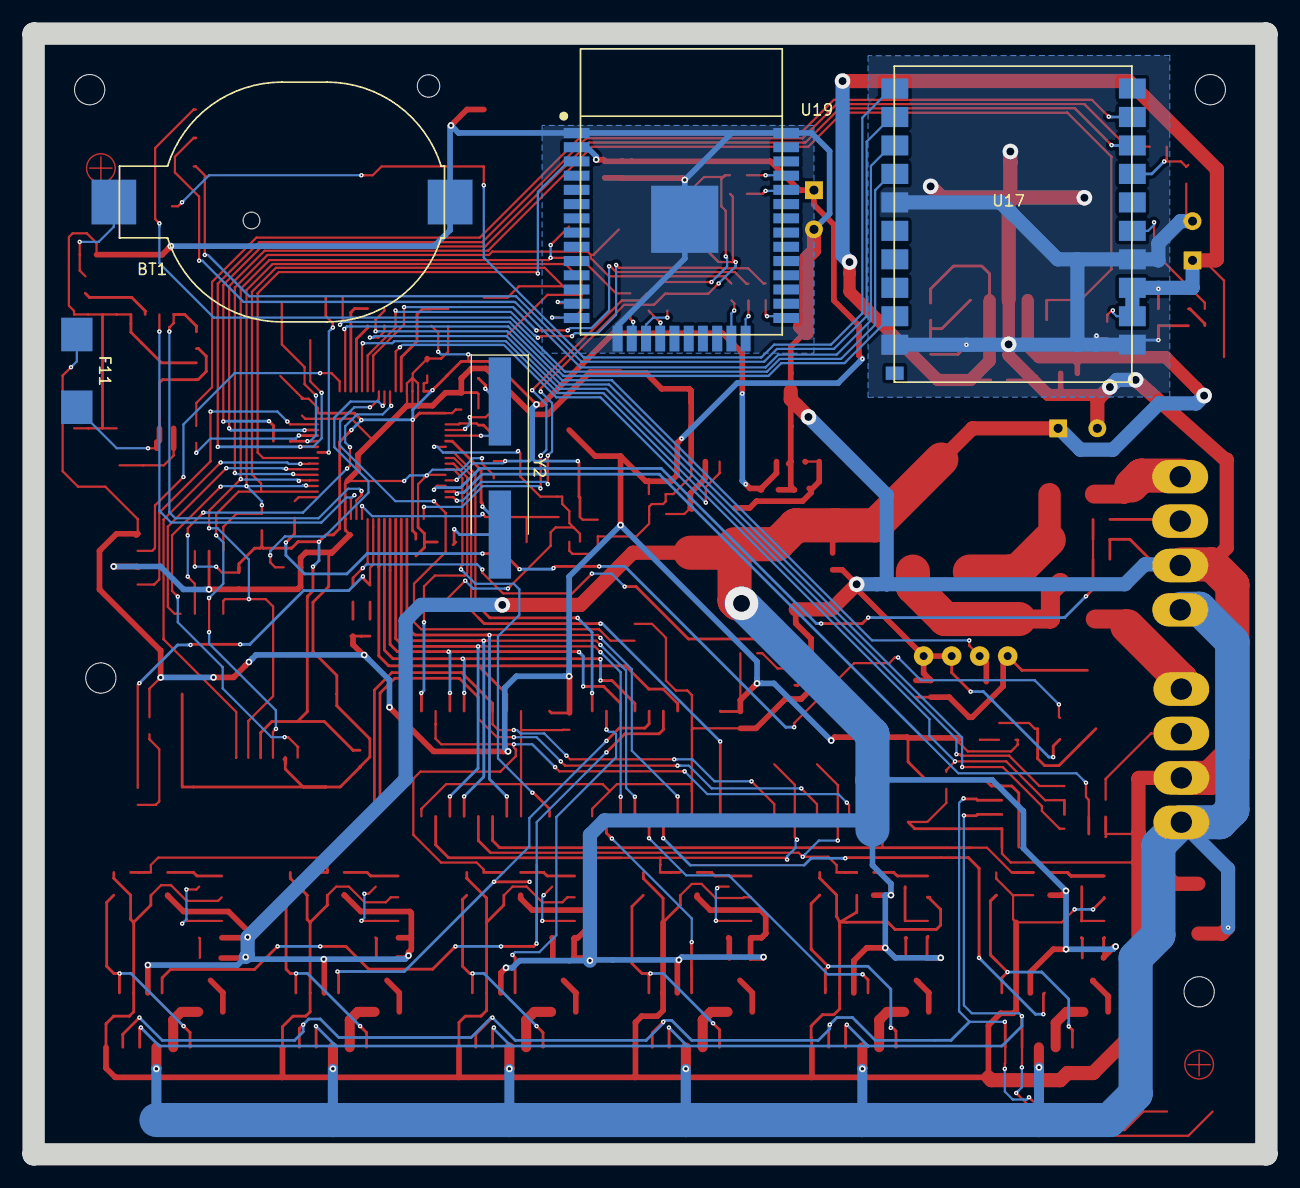
[picture p12: board test.kicad_pcb from below]

Board: 2 copper layers, 110.0 x 100.0 mm, 212 parts (5 on the bottom side), 149 nets.
