pit3rGit/HSP2/STM32CubeMX/HSP2Start/HSP2Start.ioc

Mcu.UserName=STM32L051R8Tx
PB0.Signal=GPIO_Output
PB1.Signal=GPIO_Output
