pit3rGit/HSP2/(commit log)

2017-06-01 stary IMG last
    [test.sch]
2017-06-01 Dodałem układ DHT22
    [test.sch]
2017-06-01 dodano stab gsmale jest do poprawy
    [test.sch]
2017-06-02 nowe symbole tranzystorow
    [test.sch]
2017-06-04 wlasciwy stab dla gsm
    [test.sch]
2017-06-05 Zmiana ster. wejsciami i drugi gn acu
    [test.sch]
2017-06-05 dodana dioda i przesuniecia w schemacie
    [test.sch]
2017-06-06 dodatkowe pliki z dokumentacja
    [elementy.ods]
2017-06-06 dodano część footprintów i TPS3823
    [elementy.ods, test.sch]
2017-06-12 nie pamietam
    [test.sch]
2017-06-12 wersja rev. 1.0
    [test.sch]
2017-06-13 proba BOK i footprinty
    [test.csv, test.sch]
2017-06-13 dodałem niektóre footprinty
    [test.sch]
2017-06-18 nowe footprinty
    [elementy.ods]
2017-06-20 dodałem MAX3485
    [test.sch]
2017-06-23 footprint M590E
    [test.sch]
2017-06-26 dodałem footprint do ESP-07
    [test.sch]
2017-07-10 zmiana procesora na STM32L051R8
    [test.sch]
2017-07-10 dodany footprint do stm32
    [elementy.ods, test.sch]
2017-07-11 prace przy simholder
    [test.sch]
2017-07-12 +zmiany prz uSD
    [elementy.ods, test.sch]
2017-07-13 zmiana gniazd
    [test.sch]
2017-07-17 +footprinty zlacz i 3.3VSTM
    [test.sch]
2017-07-17 poprawa footprintu stab3.3
    [test.sch]
2017-07-18 rysowanie PCB
    [bak_test.kicad_pcb, test.kicad_pcb, test.sch]
2017-07-21 łączenie ścieżek pcb
    [test.kicad_pcb, test.sch]
2017-07-23 rutowanie pcb
    [test.kicad_pcb, test.sch]
2017-07-24 sprawdzanie drc pcb
    [test.kicad_pcb, test.sch]
2017-07-26 +creo, po naprawie w pracy
    [test.kicad_pcb]
2017-07-27 +creo-weipu +zmiana dht22 i c1000
    [WEIPU_SP13_4_Pins.stp, test.kicad_pcb]
2017-07-28 +dht22 3d +mbr 3d -pliki posprzątane
    [bak_test.kicad_pcb, dht22.stl, test.kicad_pcb]
2017-07-28 +nowe modele 3d. Niedokończone routowanie dth22 w innym miejscu
    [5025840670.prt, 5025840670.stl, SOT-223-6.PRT, sot-223-6.stl, test.kicad_pcb]
2017-07-30 routowanie dht22 w nowym miejscu
    [test.kicad_pcb]
2017-07-31 przesunięcie karty sim i cr2032
    [test.kicad_pcb, test.sch]
2017-08-03 cap 3d skala +2xGSM rez
    [test.kicad_pcb, test.sch]
2017-08-09 +tp1 tp2 zmieniono strefy miedzi
    [test.kicad_pcb, test.sch]
2017-08-11 ustalanie kosztorysu
    [kosztorys.xlsx, test.csv, test.kicad_pcb, test.sch]
2017-08-21 zm kosztorys
    [kosztorys.xlsx]
2017-08-22 podmiana wifi na esp32
    [test.sch]
2017-08-25 routowanie nowego esp
    [test.kicad_pcb, test.sch]
2017-08-27 routowanie esp32
    [test.kicad_pcb]
2017-08-28 esp32 i btn zrutowanie calkowicie
    [test.kicad_pcb, test.sch]
2017-09-05 wersja final, freeze wyslana do technoservice
    [1718130004.prt, 1718130004.stl, 5025840270.prt, 5025840270.stl, kosztorys.xlsx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]
2017-09-05 zmiana flash
    [kosztorys.xlsx, test.kicad_pcb, test.sch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]
2017-09-05 poprawione przelotki i ścieżki
    [kosztorys.xlsx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]
2017-09-06 wyslane do produkcji
    [test-B.Cu.gbr, test-B.Mask.gbr, test-B.SilkS.gbr, test-Edge.Cuts.gbr, test-F.Cu.gbr, test-F.Mask.gbr, test-F.Paste.gbr, test-F.SilkS.gbr]
2018-01-10 Przed ukladaniem PCB
    [kosztorys.xlsx, zakupy_MOUSER.xlsx]
2018-01-18 pierwszy program + CubeMX
    [kosztorys.xlsx, test.csv, test.kicad_pcb]
